houseofnorth/KK_Untitled/hardware/labels/VFD cable labels Niimbot.xlsx

Label
7 VFD_24V
8 VFD_DI1
9 VFD_OK_IN
10 GND
11 VFD_AO_IN
12 GND
T1 +24V
T2 DI1
T10 OK
T11 COM
T8 AO
T9 0V
