houseofnorth/KK_Untitled/Controller/IMG_9721.png

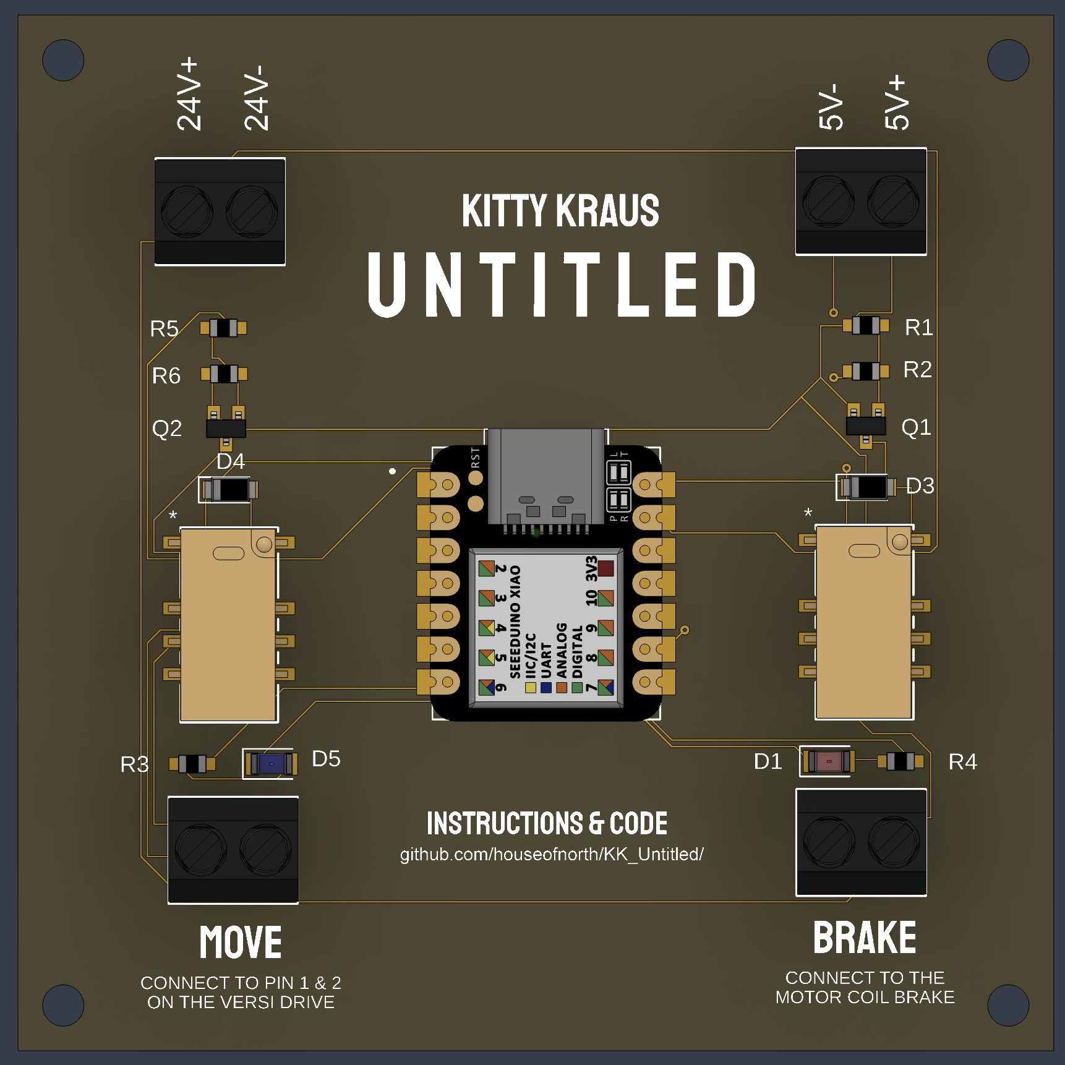
Controller/IMG_9721.png
