houseofnorth/KK_Untitled/Controller/Schematic.png

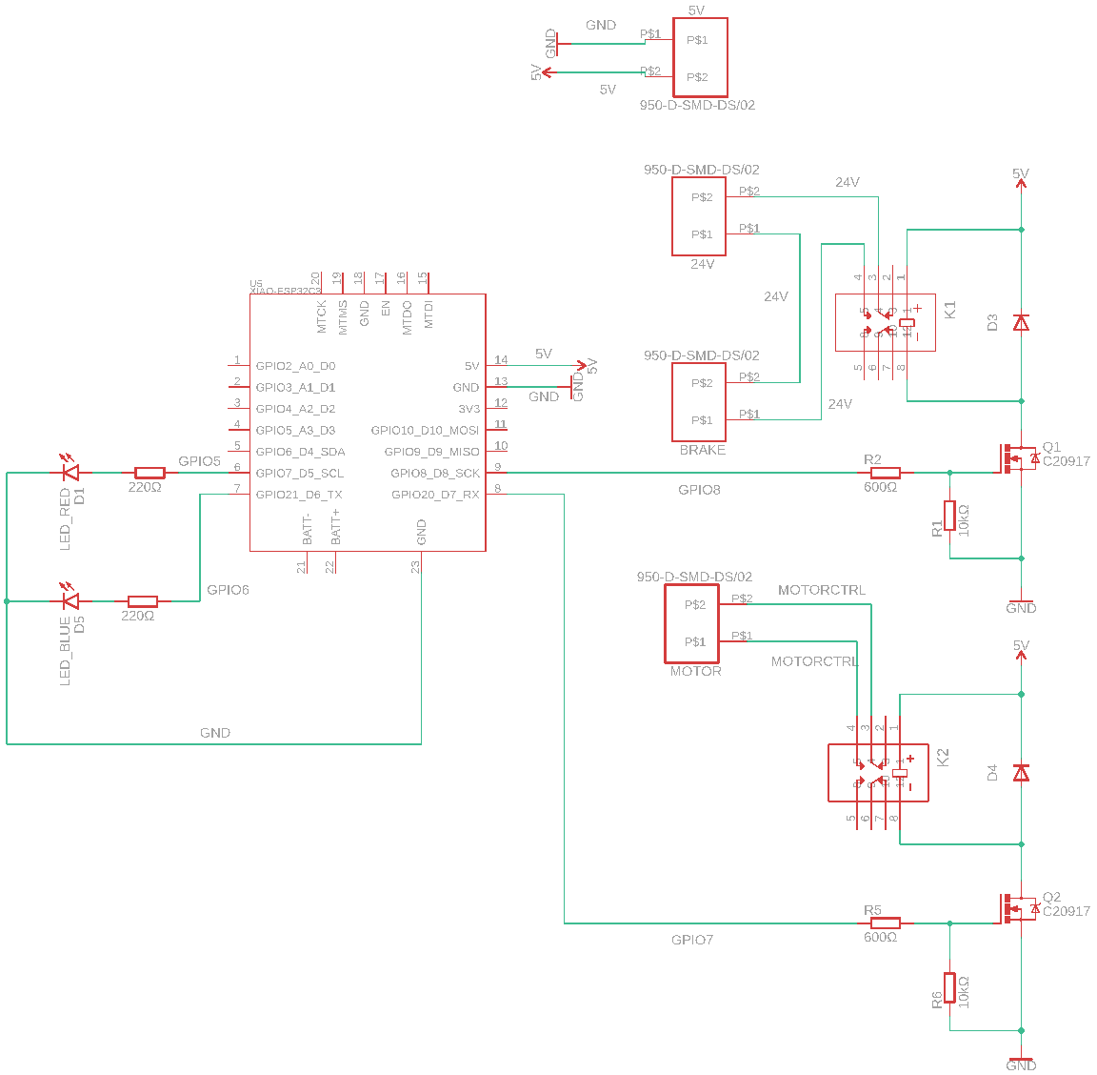
Controller/Schematic.png
