houseofnorth/KK_Untitled/hardware/Front panel.png

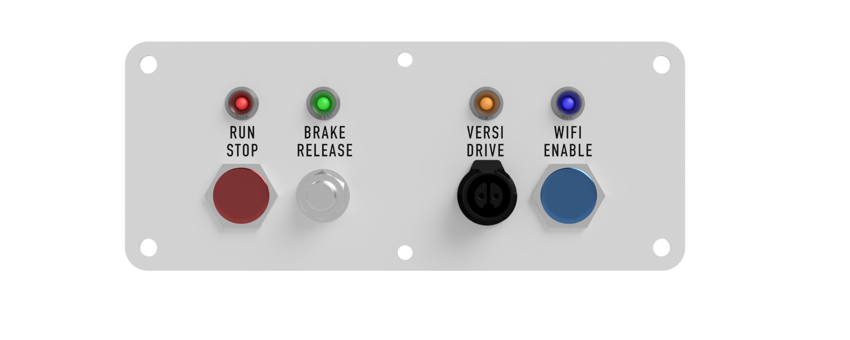
hardware/Front panel.png
