houseofnorth/KK_Untitled/firmware/Untitled/Untitled.ino

/*
------------------------------------------------------------
UNTITLED – Controller firmware (XIAO ESP32C3)
Version 1.7.8  (2026-10-18)  – keep in step with FW_VERSION below

Artist:          Kitty Kraus
Original code:   Roman Zulek (Arduino), 2011
Port / update:   Fubbi Karlsson, House of North, 2026

Behaviour (same as original):
  Run on       -> release brake, wait brakeRelease, first kick at once
  Kick         -> MOVE (VersiDrive run input) on for random spinMin..spinMax ms
  Rest         -> next kick random dropMin..dropMax ms after kick start
  Pause        -> every hangEvery..hangEveryMax ms (random): next kick in hangTime..hangTimeMax ms (random)
  Run off      -> MOVE off, brake engaged, wait brakeEngage

Added: Wi-Fi AP + mobile web page (tune, save, start/stop, test kick,
stats, OTA upload). Artist page at /, technician page at /tech,
overrides page /overrides: per-LED levels, LED test, VersiDrive check;
VersiDrive page /versidrive: documents the drive + motor nameplate, live readouts (P-08 = motorMa).
Main page nav: Main · Advanced. /tech, /overrides, /versidrive nav: all four.
Live changes apply at once; Save stores them, Undo returns to the saved state.
Wi-Fi is OFF at power-up; WIFI ENABLE switches it on (1.7.5).
AP turns off after apMinutes without use (0 = stays on): opening a page or
any action (Save, Start, slider move, ...) restarts the timer; status polling does not.

V2 options – on /overrides, saved in flash (useVfdOk and autostart ON by default, rest OFF):
  useVfdOk   VFD "drive OK" relay (VFD_OK_IN). Not OK -> move off, brake engaged.
             Resumes once OK has been stable for okResume ms. Also holds the
             piece after power-up until the drive reports ready.
  autostart  ON by default (1.6.0): mains on starts the piece (warning blink, then first push).
             Set to 0 on /tech (Settings) for installation / maintenance: the piece then stays stopped
             after power-up until RUN is held 2 s or Start is pressed.
  softKicks  First N kicks after every start ramp from 50 % to 100 % length (0 = off). Not in the UI, stays 0.

Panel buttons (1.4.0, always active, momentary to GND):
  RUN (RUN_IN)   stopped: hold 2 s = start (warning blink, then first push; may let go).
                 Short press does nothing. Starting/running: any press = stop + brake at once.
  Wi-Fi (BTN_IN) press = Wi-Fi AP on (blue blinks, then solid), or restart its timer if
                 already on. Only ever switches on; off is the idle timeout after apMinutes. NOTE: GPIO2 is a strapping pin – holding this
                 button during power-up stops the board from booting.
  Web Start/Stop behave the same as the RUN button.

Strength output – FUTURE FEATURE (V3), not fitted. hidden on /tech until fitted (page.h #future), OFF by default:
  useStr     PWM on GPIO9 (test pad) -> DFRobot GP8101S (DFR1036) set to 0-10 V -> VFD AI1 (T6).
             Strength strMin..strMax % (random), drawn after each push so the
             module output settles during the rest. Off = GPIO9 left as input.
  strInv     OFF (default) for the GP8101S: module powered from XIAO 3V3, PWM pin straight
             to GPIO9. ON only for opto-input modules wired DIN+ -> 3.3 V, DIN- -> GPIO9.
             GPIO9 is a strapping pin: the module input must not pull it low at boot.
  motorMa    VFD P-08 rated current; with P-25 = 9 the AO reads A = V(T8) x 0.2 x P-08.

Always active (indication only, cannot stop the piece):
  LED_VFD_OK  on = drive OK, breathing = not OK / not connected (stopped),
              2 Hz blink = not OK while the piece should run
  LED levels  each LED has its own level, ledRed / ledGreen / ledAmber / ledBlue (1.7.0, /overrides)
  LED_MOVE    solid = push, speeding-up blink = warning, slow breathing = running, off = stopped
  LED_SYS     Wi-Fi: 4 Hz blink while booting or starting (after WIFI ENABLE), 2 Hz blink = Wi-Fi up,
              solid = a device is connected, off = Wi-Fi off (15 min idle)
  OTA update  all four LEDs chase left to right (red, green, amber, blue)
  VFD AO      live VersiDrive analog output + peak per kick on the web page

Board: XIAO_ESP32C3 (esp32 core 3.x).
------------------------------------------------------------
*/

#include <WiFi.h>
#include <WebServer.h>
#include <ESPmDNS.h>
#include <Preferences.h>
#include <Update.h>
#include <esp_random.h>
#include "page.h"     // technician page  /tech
#include "artist.h"   // artist page      /
#include "overrides.h" // overrides page /overrides
#include "versidrive.h" // VersiDrive record /versidrive

#define FW_VERSION "1.7.8"

// --- Pins (named after the schematic nets) ---
constexpr uint8_t PIN_K1_GATE    = D10; // GPIO10 net K1_GATE   -> Q1 -> K1 : brake coil  (HIGH = brake released)
constexpr uint8_t PIN_K2_GATE    = D7;  // GPIO20 net K2_GATE   -> Q2 -> K2 : VFD_24V/VFD_DI1 contact (HIGH = run impulse)
constexpr uint8_t PIN_LED_BRAKE  = D5;  // GPIO7  net LED_BRAKE : onboard LED + panel LED via PLED_BRAKE
constexpr uint8_t PIN_LED_MOVE   = D6;  // GPIO21 net LED_MOVE  : onboard LED + panel LED via PLED_MOVE
constexpr uint8_t PIN_LED_VFD_OK = D3;  // GPIO5  net LED_VFD_OK: onboard LED3 + panel LED via PLED_VFD_OK
constexpr uint8_t PIN_LED_SYS    = D8;  // GPIO8  net LED_SYS   : LED4 + panel SYSTEM LED, ACTIVE LOW (strapping pin)
constexpr uint8_t PIN_VFD_OK_SIG = D4;  // GPIO6  net VFD_OK_SIG: drive OK relay, active low (10k pull-up)
constexpr uint8_t PIN_VFD_AO_SIG = D1;  // GPIO3  net VFD_AO_SIG: VFD analog out via 68k/10k divider
constexpr uint8_t PIN_RUN_SIG    = D2;  // GPIO4  net RUN_SIG   : RUN button, pressed = LOW (10k pull-up)
constexpr uint8_t PIN_BTN_SIG    = D0;  // GPIO2  net BTN_SIG   : Wi-Fi button, pressed = LOW (R11 pull-up, strapping pin)
constexpr uint8_t PIN_STRENGTH   = D9;  // GPIO9  test pad PIN_9 : strength PWM -> 0-10 V module -> VFD AI1 (strapping pin,
                                        //        left as input unless useStr; wire active low so it idles high)
constexpr uint32_t STR_FREQ      = 1000;  // Hz, module wants 1-3 kHz
constexpr uint8_t  STR_BITS      = 10;

constexpr float    AO_SCALE      = 7.8f;  // V at VFD terminal 8 = V at pin * 7.8
constexpr uint32_t AO_TAIL_MS    = 1500;  // keep tracking the peak this long after a kick ends
constexpr uint32_t RUN_HOLD_MS   = 2000;  // hold RUN this long to start
constexpr uint32_t BOOT_BLINK_MS = 2000;  // blue LED blinks this long after power-up
constexpr uint32_t WIFI_BLINK_MS = 1500;  // ... and after WIFI ENABLE, until Wi-Fi is up
uint32_t blueBlinkUntil = BOOT_BLINK_MS;

// --- Wi-Fi ---
const char *AP_SSID  = "Untitled";
const char *AP_PASS  = "deltitnu";       // "untitled" backwards, min 8 chars
const char *HOSTNAME = "untitled";       // http://untitled.local


// --- Config ---
struct Config {
  uint32_t spinMin, spinMax;          // ms
  uint32_t dropMin, dropMax;          // ms
  uint32_t hangEvery, hangTime;       // ms (hangEvery 0 = no pause)
  uint32_t brakeRelease, brakeEngage; // ms
  uint32_t ledPct;                    // unused since 1.7.0 (per-LED levels), kept for layout
  uint32_t apMinutes;                 // 0 = AP always on
  // --- added in CFG_VERSION 2 (V2 options) ---
  uint32_t useVfdOk;                  // 0/1
  uint32_t okResume;                  // ms drive OK must be stable before resuming
  uint32_t useRun;                    // unused since 1.4.0 (RUN is a button now), kept for layout
  uint32_t useBtn;                    // unused since 1.4.0, kept for layout
  uint32_t softKicks;                 // 0 = off
  // --- added in CFG_VERSION 3: random long pauses ---
  uint32_t hangEveryMax;              // ms, pause interval is random hangEvery..hangEveryMax
  uint32_t hangTimeMax;               // ms, pause length is random hangTime..hangTimeMax
  // --- added in CFG_VERSION 4 ---
  uint32_t warnMs;                    // Move LED speeding-up blink before each push (0 = off)
  // --- added in CFG_VERSION 5 ---
  uint32_t autostart;                 // 0/1 start on power-up
  // --- added in CFG_VERSION 6 ---
  uint32_t motorMa;                   // VFD P-08 motor rated current in mA (0 = unknown) for the A readout
  uint32_t useStr;                    // 0/1 strength PWM on GPIO9
  uint32_t strInv;                    // 1 = active low (DIN+ -> 3.3 V, DIN- -> GPIO9)
  uint32_t strMin, strMax;            // % of 0-10 V, random per push
  // --- added in CFG_VERSION 9 ---
  uint32_t vfdLedPct;                 // unused since 1.7.0, kept for layout
  // --- added in CFG_VERSION 11: per-LED levels, set on /overrides ---
  uint32_t ledRed, ledGreen, ledAmber, ledBlue;   // % 0..100
};
const Config DEFAULTS = {200, 900, 10000, 45000, 600000, 60000, 1250, 1250, 50, 15,
                         1, 5000, 0, 0, 0,
                         600000, 60000,
                         3000,
                         1,
                         0, 0, 0, 40, 100,
                         60,
                         50, 50, 30, 50};
constexpr uint32_t CFG_VERSION = 11;  // 9: + vfdLedPct · 10: autostart on by default · 11: per-LED levels
constexpr size_t   CFG_V10_SIZE = 25 * sizeof(uint32_t);
constexpr size_t   CFG_V9_SIZE = 25 * sizeof(uint32_t);
constexpr size_t   CFG_V8_SIZE = 24 * sizeof(uint32_t);
// 7: Stop on VFD fault on by default · 8: strength output active high (GP8101S)
constexpr size_t   CFG_V7_SIZE = 24 * sizeof(uint32_t);
constexpr size_t   CFG_V6_SIZE = 24 * sizeof(uint32_t);
constexpr size_t   CFG_V5_SIZE = 19 * sizeof(uint32_t);
constexpr size_t   CFG_V1_SIZE = 10 * sizeof(uint32_t);
constexpr size_t   CFG_V2_SIZE = 15 * sizeof(uint32_t);
constexpr size_t   CFG_V3_SIZE = 17 * sizeof(uint32_t);
constexpr size_t   CFG_V4_SIZE = 18 * sizeof(uint32_t);

Config cfg;
uint32_t cfgRev = 0;               // bumps on every settings change, pages re-sync on it
Config savedCfg;                   // what is in flash; cfg may hold live (unsaved) changes
Preferences prefs;
WebServer server(80);

// --- State ---
enum Phase : uint8_t { STOPPED, RELEASING, WAITING, KICKING, ENGAGING };
const char *PHASE_NAMES[] = {"stopped", "releasing brake", "resting", "kick", "engaging brake"};

Phase    phase = STOPPED;
bool     userRun = false;     // wanted on/off (web Start/Stop, RUN button)
bool     running = false;     // actually running
bool     inPause = false;     // current rest is a hangout pause
bool     brakeReleased = false, moveOn = false;
uint32_t phaseStart = 0, kickStart = 0, kickLen = 0, nextKick = 0, hangoutAt = 0;
uint32_t lastSpin = 0, lastDrop = 0, kicks = 0, pauses = 0, bootCount = 0;
uint32_t kicksSinceStart = 0, vfdFaults = 0, lastPause = 0;
int32_t  lastStr = -1;                     // strength % of the last push, -1 = output off
float    warnPhase = 0;                    // Move LED warning blink phase
bool     warnWas = false;
bool     faultActive = false;
bool     apOn = false, webReady = false;
uint32_t apSince = 0;
bool     otaActive = false;

// AO feedback
float    aoV = 0;                         // smoothed V at terminal 8
float    aoPeak = 0, aoLastPeak = -1, aoAvgPeak = -1;
bool     aoTracking = false;

// ---------- Inputs (all active low, debounced) ----------
struct Input {
  uint8_t  pin;
  uint16_t debounce;
  bool     state, raw;
  uint32_t since;          // when raw last changed
  void begin(uint32_t now) { pinMode(pin, INPUT); raw = state = digitalRead(pin) == LOW; since = now; }
  bool update(uint32_t now) {               // true when state changed
    bool r = digitalRead(pin) == LOW;
    if (r != raw) { raw = r; since = now; return false; }
    if (r != state && now - since >= debounce) { state = r; return true; }
    return false;
  }
  uint32_t stableFor(uint32_t now) const { return raw == state ? now - since : 0; }
};
Input inVfdOk = {PIN_VFD_OK_SIG, 300};   // true = drive OK
Input inRun   = {PIN_RUN_SIG,    30};    // true = RUN pressed
Input inBtn   = {PIN_BTN_SIG,    40};    // true = Wi-Fi pressed
uint32_t runDownAt = 0;
bool     runArmed = false;               // press began while stopped -> may start after RUN_HOLD_MS

// ---------- Outputs ----------
uint32_t duty(uint32_t pct) { return (255 * pct) / 100; }   // LED % -> 8-bit PWM
bool     ledTest = false;          // /overrides: all LEDs solid at their levels
uint32_t ledTestUntil = 0;         // test ends by itself unless the page keeps pinging

void setBrakeReleased(bool on) {
  brakeReleased = on;
  digitalWrite(PIN_K1_GATE, on ? HIGH : LOW);   // brake LED follows in tickIndicators
}

void setMove(bool on) {
  moveOn = on;
  digitalWrite(PIN_K2_GATE, on ? HIGH : LOW);   // move LED follows in tickIndicators
}

void safeOutputs() { setMove(false); setBrakeReleased(false); }

uint32_t randRange(uint32_t lo, uint32_t hi) {
  if (hi <= lo) return lo;
  return lo + (esp_random() % (hi - lo + 1));
}

// ---------- Strength output (GPIO9 PWM -> 0-10 V module -> VFD AI1) ----------
uint32_t strNow = 0;              // % for the next / current push
bool     strAttached = false;

void writeStrength() {            // attach/detach as useStr says, then write strNow
  if (!cfg.useStr) {
    if (strAttached) { ledcDetach(PIN_STRENGTH); strAttached = false; }
    pinMode(PIN_STRENGTH, INPUT);  // untouched: pad floats on its pull-up
    return;
  }
  if (!strAttached) { ledcAttach(PIN_STRENGTH, STR_FREQ, STR_BITS); strAttached = true; }
  const uint32_t full = (1u << STR_BITS) - 1;
  uint32_t duty = full * strNow / 100;
  ledcWrite(PIN_STRENGTH, cfg.strInv ? full - duty : duty);
}

void drawStrength() {             // new random strength, set well before the push
  strNow = randRange(cfg.strMin, cfg.strMax);
  writeStrength();
}

inline bool reached(uint32_t now, uint32_t t) { return (int32_t)(now - t) >= 0; }
inline bool blink(uint32_t now, uint32_t period) { return (now / (period / 2)) & 1; }

// ---------- Config storage ----------
void clampConfig(Config &c) {
  auto clamp = [](uint32_t &v, uint32_t lo, uint32_t hi) { v = v < lo ? lo : (v > hi ? hi : v); };
  clamp(c.spinMin, 20, 20000);     clamp(c.spinMax, 20, 20000);
  clamp(c.dropMin, 500, 3600000);  clamp(c.dropMax, 500, 3600000);
  clamp(c.hangEvery, 0, 86400000); clamp(c.hangTime, 0, 3600000);
  clamp(c.brakeRelease, 0, 10000); clamp(c.brakeEngage, 0, 10000);
  clamp(c.ledPct, 0, 100);         clamp(c.apMinutes, 0, 1440);
  clamp(c.useVfdOk, 0, 1);         clamp(c.okResume, 500, 600000);
  clamp(c.useRun, 0, 1);           clamp(c.useBtn, 0, 1);
  clamp(c.autostart, 0, 1);
  clamp(c.motorMa, 0, 50000);      clamp(c.useStr, 0, 1);  clamp(c.strInv, 0, 1);
  clamp(c.strMin, 0, 100);         clamp(c.strMax, 0, 100);
  clamp(c.vfdLedPct, 0, 100);
  clamp(c.ledRed, 0, 100);   clamp(c.ledGreen, 0, 100);
  clamp(c.ledAmber, 0, 100); clamp(c.ledBlue, 0, 100);
  if (c.strMax < c.strMin) std::swap(c.strMin, c.strMax);
  clamp(c.softKicks, 0, 50);
  clamp(c.hangEveryMax, 60000, 86400000); clamp(c.hangTimeMax, 0, 3600000);
  clamp(c.warnMs, 0, 10000);
  if (c.hangEvery && c.hangEvery < 60000) c.hangEvery = 60000;   // 0 = no long pauses
  if (c.hangEvery && c.hangEveryMax < c.hangEvery) std::swap(c.hangEvery, c.hangEveryMax);
  if (c.hangTimeMax < c.hangTime) std::swap(c.hangTime, c.hangTimeMax);
  if (c.spinMax < c.spinMin) std::swap(c.spinMin, c.spinMax);
  if (c.dropMax < c.dropMin) std::swap(c.dropMin, c.dropMax);
}

void saveConfig() {
  prefs.putBytes("cfg", &cfg, sizeof(Config));
  prefs.putUInt("ver", CFG_VERSION);
  savedCfg = cfg;
}

bool configDirty() { return memcmp(&cfg, &savedCfg, sizeof(Config)) != 0; }

void loadConfig() {
  cfg = DEFAULTS;
  uint32_t ver = prefs.getUInt("ver", 0);
  size_t   len = prefs.getBytesLength("cfg");
  if (ver == CFG_VERSION && len == sizeof(Config)) {
    prefs.getBytes("cfg", &cfg, sizeof(Config));
  } else if ((ver == 1 && len == CFG_V1_SIZE) || (ver == 2 && len == CFG_V2_SIZE) ||
             (ver == 3 && len == CFG_V3_SIZE) || (ver == 4 && len == CFG_V4_SIZE) ||
             (ver == 5 && len == CFG_V5_SIZE) || (ver == 6 && len == CFG_V6_SIZE) ||
             (ver == 7 && len == CFG_V7_SIZE) || (ver == 8 && len == CFG_V8_SIZE) ||
             (ver == 9 && len == CFG_V9_SIZE) || (ver == 10 && len == CFG_V10_SIZE)) {
    // keep tuned settings; fields added later keep their DEFAULTS
    prefs.getBytes("cfg", &cfg, len);
    if (ver < 7) cfg.useVfdOk = 1;     // 1.5.1: Stop on VFD fault on by default
    if (ver < 10) cfg.autostart = 1;   // 1.6.0: mains on starts the piece
    if (ver < 8) cfg.strInv = 0;       // 1.5.3: GP8101S takes the PWM active high
    if (ver < 11) {                    // 1.7.0: per-LED levels start from the old global level
      cfg.ledRed = cfg.ledGreen = cfg.ledBlue = cfg.ledPct;
      cfg.ledAmber = ver >= 9 ? cfg.ledPct * cfg.vfdLedPct / 100 : cfg.ledPct;
    }
    if (ver < 3) {                     // pause ranges start as the old fixed values
      cfg.hangEveryMax = cfg.hangEvery ? cfg.hangEvery : DEFAULTS.hangEveryMax;
      cfg.hangTimeMax  = cfg.hangTime;
    }
    clampConfig(cfg);
    saveConfig();
    Serial.printf("Config migrated from v%lu\n", ver);
  }
  clampConfig(cfg);
  savedCfg = cfg;
}

// ---------- Piece logic ----------
void startPiece() {
  if (running) return;
  running = true;
  inPause = false;
  kicksSinceStart = 0;
  drawStrength();
  setMove(false);
  setBrakeReleased(true);
  phase = RELEASING;
  phaseStart = millis();
  nextKick = phaseStart + max(cfg.brakeRelease, cfg.warnMs);   // first push after release + warning
  Serial.println("RUN: brake released");
}

void stopPiece() {
  if (!running) return;
  running = false;
  inPause = false;
  setMove(false);
  setBrakeReleased(false);
  phase = ENGAGING;
  phaseStart = millis();
  Serial.println("STOP: move off, brake engaged");
}

void startKick(uint32_t now) {
  kickLen  = randRange(cfg.spinMin, cfg.spinMax);
  if (cfg.softKicks && kicksSinceStart < cfg.softKicks)          // ramp 50 % -> 100 %
    kickLen = kickLen * (50 + 50 * kicksSinceStart / cfg.softKicks) / 100;
  kicksSinceStart++;
  lastDrop = randRange(cfg.dropMin, cfg.dropMax);
  lastSpin = kickLen;
  lastStr  = cfg.useStr ? (int32_t)strNow : -1;
  kickStart = now;
  nextKick  = now + lastDrop;      // measured from kick start, as original
  inPause = false;
  kicks++;
  aoPeak = 0;
  aoTracking = true;
  setMove(true);
  phase = KICKING;
  Serial.printf("KICK #%lu: %lu ms, next in %lu ms\n", kicks, kickLen, lastDrop);
}

void tickPiece(uint32_t now) {
  switch (phase) {
    case RELEASING:
      if (now - phaseStart >= cfg.brakeRelease) {
        // nextKick was set in startPiece (brake release + warning)
        hangoutAt = now + randRange(cfg.hangEvery, cfg.hangEveryMax);
        phase = WAITING;
      }
      break;
    case WAITING:
      if (cfg.hangEvery && reached(now, hangoutAt)) {
        hangoutAt = now + randRange(cfg.hangEvery, cfg.hangEveryMax);
        lastPause = randRange(cfg.hangTime, cfg.hangTimeMax);
        nextKick  = now + lastPause;
        inPause = true;
        pauses++;
        Serial.printf("PAUSE: %lu ms, next pause in %lu ms\n", lastPause, hangoutAt - now);
      } else if (reached(now, nextKick)) {
        startKick(now);
      }
      break;
    case KICKING:
      if (now - kickStart >= kickLen) {
        setMove(false);
        phase = WAITING;
        drawStrength();             // next push's strength, settles during the rest
      }
      break;
    case ENGAGING:
      if (now - phaseStart >= cfg.brakeEngage) phase = STOPPED;
      break;
    case STOPPED:
      break;
  }
}

// ---------- Inputs decide whether the piece may run ----------
const char *holdReason() {
  if (!userRun)    return "stopped";
  if (faultActive) return "VFD fault";
  return "";
}

void startAP();
void stopAP();

void tickInputs(uint32_t now) {
  // VFD drive OK
  if (inVfdOk.update(now)) Serial.printf(">> VFD_OK %s\n", inVfdOk.state ? "OK" : "NOT OK");
  if (cfg.useVfdOk) {
    if (!inVfdOk.state && !faultActive) {
      faultActive = true;
      if (running) { vfdFaults++; Serial.println("VFD FAULT: holding piece"); }
    } else if (faultActive && inVfdOk.state && inVfdOk.stableFor(now) >= cfg.okResume) {
      faultActive = false;
      Serial.println("VFD OK: resuming");
    }
  } else {
    faultActive = false;
  }

  // RUN button: starting/running -> any press stops at once; stopped -> hold RUN_HOLD_MS to start
  if (inRun.update(now) && inRun.state) {
    if (userRun) {
      userRun = false; runArmed = false;
      Serial.println("RUN button: stop");
    } else {
      runDownAt = now; runArmed = true;
    }
  }
  if (!inRun.state) runArmed = false;    // released before 2 s: nothing
  if (runArmed && now - runDownAt >= RUN_HOLD_MS) {
    runArmed = false;
    userRun = true;                      // warning blink starts now, operator may let go
    Serial.println("RUN button: start");
  }

  // Wi-Fi button: only ever switches Wi-Fi on (or restarts its 15 min if already on);
  // the blue LED blinks while it starts, then goes solid
  if (inBtn.update(now) && inBtn.state && !otaActive) {
    if (!apOn) startAP();
    apSince = millis();
    blueBlinkUntil = millis() + WIFI_BLINK_MS;
    Serial.println("Wi-Fi button: AP on, timer restarted");
  }

  // Apply
  bool want = userRun && !faultActive;
  if (want && !running) startPiece();
  else if (!want && running) stopPiece();
}

void tickAO(uint32_t now) {
  static uint32_t last = 0;
  if (now - last < 20) return;
  last = now;
  float v = analogReadMilliVolts(PIN_VFD_AO_SIG) * AO_SCALE / 1000.0f;
  aoV = aoV * 0.7f + v * 0.3f;
  if (aoTracking) {
    if (aoV > aoPeak) aoPeak = aoV;
    if (phase != KICKING && now - kickStart >= kickLen + AO_TAIL_MS) {
      aoTracking = false;
      aoLastPeak = aoPeak;
      aoAvgPeak  = aoAvgPeak < 0 ? aoPeak : aoAvgPeak * 0.8f + aoPeak * 0.2f;
    }
  }
}

bool moveWarning(uint32_t now) {
  return cfg.warnMs && running && !otaActive && (phase == RELEASING || phase == WAITING) &&
         (int32_t)(nextKick - now) <= (int32_t)cfg.warnMs;
}

// Slow breathing: 10 % .. 100 % of the LED's level (full = its duty), cosine fade.
// t0 = when breathing started; it starts at full brightness and fades down,
// so it joins smoothly onto a solid or blinking LED.
uint32_t breathe(uint32_t now, uint32_t period, uint32_t t0, uint32_t full) {
  float x = 0.5f + 0.5f * cosf(6.2831853f * (float)((now - t0) % period) / period);   // 1..0..1
  float lvl = 0.10f + 0.90f * x * x;                                                   // eased, perceptual
  return (uint32_t)(full * lvl);
}

void tickIndicators(uint32_t now) {
  const uint32_t R = duty(cfg.ledRed), G = duty(cfg.ledGreen), A = duty(cfg.ledAmber), B = duty(cfg.ledBlue);
  if (ledTest && !reached(now, ledTestUntil)) {   // /overrides LED test: all solid at their levels
    ledcWrite(PIN_LED_MOVE, R); ledcWrite(PIN_LED_BRAKE, G);
    ledcWrite(PIN_LED_VFD_OK, A); ledcWrite(PIN_LED_SYS, 256 - B);
    return;
  }
  ledTest = false;
  if (otaActive) {                              // firmware upload: chase left to right, red -> blue
    const uint8_t pins[4] = {PIN_LED_MOVE, PIN_LED_BRAKE, PIN_LED_VFD_OK, PIN_LED_SYS};
    const uint32_t lvl[4] = {R, G, A, B};
    uint8_t step = (now / 120) % 4;
    for (uint8_t i = 0; i < 4; i++) {
      uint32_t d = i == step ? lvl[i] : (i == (step + 3) % 4 ? lvl[i] / 5 : 0);   // lit + short tail
      ledcWrite(pins[i], pins[i] == PIN_LED_SYS ? 256 - d : d);
    }
    return;
  }
  ledcWrite(PIN_LED_BRAKE, brakeReleased ? G : 0);
  // VFD LED: on = drive OK, breathing = not OK / not connected while stopped,
  //          2 Hz blink = not OK while the piece should run (fault)
  static uint32_t vbStart = 0;
  static bool vbWas = false;
  bool vb = !inVfdOk.state && !userRun;
  if (vb && !vbWas) vbStart = now;            // breathing starts at full brightness
  vbWas = vb;
  uint32_t vDuty;
  if (inVfdOk.state)  vDuty = A;
  else if (userRun)   vDuty = blink(now, 500) ? A : 0;
  else                vDuty = breathe(now, 3000, vbStart, A);
  ledcWrite(PIN_LED_VFD_OK, vDuty);
  // System LED (active low) = Wi-Fi: fast blink while booting / starting, 2 Hz blink = Wi-Fi up
  // (same tempo as the amber fault blink), solid = a device is connected, off = Wi-Fi off
  // (OTA: chase, handled above)
  static uint32_t lastSta = 0;
  static uint8_t  sta = 0;
  if (now - lastSta >= 500) { lastSta = now; sta = apOn ? WiFi.softAPgetStationNum() : 0; }
  uint32_t sDuty;
  if (!reached(now, blueBlinkUntil)) sDuty = blink(now, 250) ? B : 0;   // booting / Wi-Fi starting
  else if (!apOn)                    sDuty = 0;                          // Wi-Fi off
  else if (sta > 0)                  sDuty = B;                          // device connected: solid
  else                               sDuty = blink(now, 500) ? B : 0;   // Wi-Fi up, waiting: 2 Hz
  ledcWrite(PIN_LED_SYS, 256 - sDuty);              // active low: 256 = pin held high = fully off

  // Move LED, highest first: solid while pushing; speeding-up blink during the
  // warning before a push; slow breathing while running between pushes; off when stopped
  static uint32_t lastT = 0;
  uint32_t dt = now - lastT; lastT = now;
  bool warn = moveWarning(now);
  if (warn && !warnWas) warnPhase = 0;
  warnWas = warn;
  static uint32_t brStart = 0;
  static bool brWas = false;
  uint32_t mDuty = 0;
  bool br = !moveOn && !warn && running && !otaActive;
  if (br && !brWas) brStart = now;            // start each breathing spell at full brightness
  brWas = br;
  if (moveOn) {
    mDuty = R;
  } else if (warn) {
    float f = 1.0f - (float)(int32_t)(nextKick - now) / cfg.warnMs;   // 0 -> 1 over the warning
    if (f < 0) f = 0;
    float period = 700.0f - 620.0f * f;                               // 700 ms -> 80 ms
    warnPhase += dt / period;
    mDuty = (warnPhase - (int)warnPhase) < 0.5f ? R : 0;
  } else if (br) {
    mDuty = breathe(now, 3000, brStart, R);
  }
  ledcWrite(PIN_LED_MOVE, mDuty);
}

// ---------- Web ----------
void sendJson(const String &s) {
  server.sendHeader("Cache-Control", "no-store");
  server.send(200, "application/json", s);
}

String configJson() {
  char b[1000];
  snprintf(b, sizeof b,
    "{\"spinMin\":%lu,\"spinMax\":%lu,\"dropMin\":%lu,\"dropMax\":%lu,"
    "\"hangEvery\":%lu,\"hangTime\":%lu,\"brakeRelease\":%lu,\"brakeEngage\":%lu,"
    "\"ledRed\":%lu,\"ledGreen\":%lu,\"ledAmber\":%lu,\"ledBlue\":%lu,\"apMinutes\":%lu,"
    "\"useVfdOk\":%lu,\"okResume\":%lu,\"useRun\":%lu,\"useBtn\":%lu,\"softKicks\":%lu,"
    "\"hangEveryMax\":%lu,\"hangTimeMax\":%lu,\"warnMs\":%lu,\"autostart\":%lu,"
    "\"motorMa\":%lu,\"useStr\":%lu,\"strInv\":%lu,\"strMin\":%lu,\"strMax\":%lu,\"rev\":%lu}",
    cfg.spinMin, cfg.spinMax, cfg.dropMin, cfg.dropMax, cfg.hangEvery, cfg.hangTime,
    cfg.brakeRelease, cfg.brakeEngage, cfg.ledRed, cfg.ledGreen, cfg.ledAmber, cfg.ledBlue, cfg.apMinutes,
    cfg.useVfdOk, cfg.okResume, cfg.useRun, cfg.useBtn, cfg.softKicks,
    cfg.hangEveryMax, cfg.hangTimeMax, cfg.warnMs, cfg.autostart,
    cfg.motorMa, cfg.useStr, cfg.strInv, cfg.strMin, cfg.strMax, cfgRev);
  return String(b);
}

String statusJson() {
  uint32_t now = millis();
  long nextKickIn = (running && phase == WAITING) ? (long)(int32_t)(nextKick - now) : -1;
  long pauseIn    = (running && cfg.hangEvery && phase != RELEASING) ? (long)(int32_t)(hangoutAt - now) : -1;
  long apOffIn    = (apOn && cfg.apMinutes) ? max(0L, (long)cfg.apMinutes * 60000L - (long)(now - apSince)) : -1;
  const char *ph  = (phase == WAITING && inPause) ? "pause" : PHASE_NAMES[phase];
  char b[1100];
  snprintf(b, sizeof b,
    "{\"fw\":\"%s\",\"running\":%s,\"userRun\":%s,\"hold\":\"%s\",\"phase\":\"%s\",\"brake\":%s,\"move\":%s,"
    "\"uptime\":%lu,\"boots\":%lu,\"kicks\":%lu,\"pauses\":%lu,\"lastSpin\":%lu,\"lastDrop\":%lu,"
    "\"nextKickIn\":%ld,\"pauseIn\":%ld,\"apOffIn\":%ld,\"clients\":%d,\"heap\":%lu,"
    "\"vfdOk\":%s,\"runSw\":%s,\"btn\":%s,\"faults\":%lu,\"ao\":%.2f,\"aoPeak\":%.2f,\"aoAvg\":%.2f,"
    "\"dirty\":%s,\"hangTime\":%lu,\"warn\":%s,\"str\":%ld,\"lastStr\":%ld,\"ledTest\":%s,\"rev\":%lu}",
    FW_VERSION, running ? "true" : "false", userRun ? "true" : "false",
    running ? "" : holdReason(), ph,
    brakeReleased ? "\"released\"" : "\"engaged\"", moveOn ? "true" : "false",
    now / 1000, bootCount, kicks, pauses, lastSpin, lastDrop,
    nextKickIn, pauseIn, apOffIn, WiFi.softAPgetStationNum(),
    (unsigned long)ESP.getFreeHeap(),
    inVfdOk.state ? "true" : "false", inRun.state ? "true" : "false", inBtn.state ? "true" : "false",
    vfdFaults, aoV, aoLastPeak, aoAvgPeak,
    configDirty() ? "true" : "false", lastPause, moveWarning(now) ? "true" : "false",
    cfg.useStr ? (long)strNow : -1L, (long)lastStr,
    (ledTest && !reached(now, ledTestUntil)) ? "true" : "false", cfgRev);
  return String(b);
}

// Read config fields from the request (missing ones keep their current value)
Config configFromArgs() {
  Config c = cfg;
  auto rd = [](const char *k, uint32_t &v) {
    if (server.hasArg(k)) { long x = server.arg(k).toInt(); v = x < 0 ? 0 : (uint32_t)x; }
  };
  rd("spinMin", c.spinMin);   rd("spinMax", c.spinMax);
  rd("dropMin", c.dropMin);   rd("dropMax", c.dropMax);
  rd("hangEvery", c.hangEvery); rd("hangTime", c.hangTime);
  rd("brakeRelease", c.brakeRelease); rd("brakeEngage", c.brakeEngage);
  rd("ledRed", c.ledRed);     rd("ledGreen", c.ledGreen);
  rd("ledAmber", c.ledAmber); rd("ledBlue", c.ledBlue);
  rd("apMinutes", c.apMinutes);
  rd("useVfdOk", c.useVfdOk); rd("okResume", c.okResume);
  rd("useRun", c.useRun);     rd("useBtn", c.useBtn);
  rd("softKicks", c.softKicks);
  rd("hangEveryMax", c.hangEveryMax); rd("hangTimeMax", c.hangTimeMax);
  rd("warnMs", c.warnMs);
  rd("autostart", c.autostart);
  rd("motorMa", c.motorMa);   rd("useStr", c.useStr);   rd("strInv", c.strInv);
  rd("strMin", c.strMin);     rd("strMax", c.strMax);
  clampConfig(c);
  return c;
}

// Make a config active right away (not saved)
void applyConfig(const Config &c) {
  Config old = cfg;
  cfg = c;
  if (memcmp(&old, &cfg, sizeof(Config)) != 0) cfgRev++;
  uint32_t now = millis();
  if (running && cfg.hangEvery && (cfg.hangEvery != old.hangEvery || cfg.hangEveryMax != old.hangEveryMax))
    hangoutAt = now + randRange(cfg.hangEvery, cfg.hangEveryMax);
  // New rest range: re-draw the current rest so the change is felt at once
  if (running && phase == WAITING && !inPause &&
      (cfg.dropMin != old.dropMin || cfg.dropMax != old.dropMax)) {
    lastDrop = randRange(cfg.dropMin, cfg.dropMax);
    nextKick = kickStart + lastDrop;
  }
  if (cfg.useStr != old.useStr || cfg.strInv != old.strInv ||
      cfg.strMin != old.strMin || cfg.strMax != old.strMax) {
    if (moveOn) writeStrength();     // mid-push: keep this push's value
    else drawStrength();
  }
  tickInputs(now);                   // apply option changes at once
}

void setupWeb() {
  server.on("/", HTTP_GET, [] { apSince = millis();
    server.sendHeader("Cache-Control", "no-store");
    server.send_P(200, "text/html", ARTIST_HTML);
  });
  server.on("/tech", HTTP_GET, [] { apSince = millis();
    server.sendHeader("Cache-Control", "no-store");
    server.send_P(200, "text/html", INDEX_HTML);
  });
  server.on("/overrides", HTTP_GET, [] { apSince = millis();   // linked from /tech and /versidrive only
    server.sendHeader("Cache-Control", "no-store");
    server.send_P(200, "text/html", OVERRIDES_HTML);
  });
  server.on("/versidrive", HTTP_GET, [] { apSince = millis();
    server.sendHeader("Cache-Control", "no-store");
    server.send_P(200, "text/html", VERSIDRIVE_HTML);
  });
  server.on("/setup", HTTP_GET, [] { server.sendHeader("Location", "/versidrive"); server.send(302); });
  server.on("/api/setup", HTTP_GET, [] {             // site record, stored as-is
    String d = prefs.getString("setup", "{}");
    sendJson(d.length() ? d : String("{}"));
  });
  server.on("/api/setup", HTTP_POST, [] { apSince = millis();   // activity keeps Wi-Fi on
    String d = server.arg("d");
    if (!d.startsWith("{") || d.length() > 2500) { server.send(400, "text/plain", "bad"); return; }
    prefs.putString("setup", d);
    sendJson(d);
  });
  server.on("/api/ledtest", HTTP_POST, [] { apSince = millis();         // on=1 holds all LEDs solid for 10 s, page pings
    ledTest = server.arg("on") == "1";
    ledTestUntil = millis() + 10000;
    sendJson(statusJson());
  });
  server.on("/api/status", HTTP_GET, [] { sendJson(statusJson()); });
  server.on("/api/config", HTTP_GET, [] { sendJson(configJson()); });
  server.on("/api/config", HTTP_POST, [] { apSince = millis();           // apply + save
    applyConfig(configFromArgs()); saveConfig();
    Serial.println("Config saved");
    sendJson(configJson());
  });
  server.on("/api/live", HTTP_POST, [] { apSince = millis();             // apply, not saved
    applyConfig(configFromArgs());
    sendJson(configJson());
  });
  server.on("/api/revert", HTTP_POST, [] { apSince = millis();           // back to the saved config
    applyConfig(savedCfg);
    sendJson(configJson());
  });
  server.on("/api/defaults", HTTP_POST, [] { apSince = millis();   // activity keeps Wi-Fi on
    applyConfig(DEFAULTS); saveConfig();
    sendJson(configJson());
  });
  server.on("/api/start", HTTP_POST, [] { apSince = millis(); userRun = true;  tickInputs(millis()); sendJson(statusJson()); });
  server.on("/api/stop",  HTTP_POST, [] { apSince = millis(); userRun = false; tickInputs(millis()); sendJson(statusJson()); });
  server.on("/api/kick",  HTTP_POST, [] { apSince = millis();            // push after the warning
    uint32_t now = millis(), due = now + cfg.warnMs;
    if (running && phase == WAITING && (int32_t)(nextKick - due) > 0) {
      nextKick = due; lastDrop = nextKick - kickStart; inPause = false;
    }
    sendJson(statusJson());
  });
  server.on("/api/wifi", HTTP_POST, [] { apSince = millis();             // restart the Wi-Fi off timer
    apSince = millis();
    sendJson(statusJson());
  });
  server.on("/api/reboot", HTTP_POST, [] { apSince = millis();   // activity keeps Wi-Fi on
    server.send(200, "text/plain", "rebooting");
    safeOutputs(); delay(300); ESP.restart();
  });

  // OTA: upload Untitled.ino.bin
  server.on("/update", HTTP_POST, [] { apSince = millis();   // activity keeps Wi-Fi on
    bool ok = !Update.hasError();
    server.sendHeader("Connection", "close");
    server.send(ok ? 200 : 500, "text/plain", ok ? "OK" : Update.errorString());
    otaActive = false;
    if (ok) { prefs.putBool("wifiNext", true); delay(500); ESP.restart(); }   // Wi-Fi back on after the update
  }, [] {
    HTTPUpload &up = server.upload();
    if (up.status == UPLOAD_FILE_START) {
      otaActive = true;
      running = false; phase = STOPPED; safeOutputs();   // piece safe during update
      Serial.printf("OTA start: %s\n", up.filename.c_str());
      if (!Update.begin(UPDATE_SIZE_UNKNOWN)) Update.printError(Serial);
    } else if (up.status == UPLOAD_FILE_WRITE) {
      if (Update.write(up.buf, up.currentSize) != up.currentSize) Update.printError(Serial);
      tickIndicators(millis());                      // keep the chase running during the upload
    } else if (up.status == UPLOAD_FILE_END) {
      if (Update.end(true)) Serial.printf("OTA done: %u bytes\n", up.totalSize);
      else Update.printError(Serial);
    } else if (up.status == UPLOAD_FILE_ABORTED) {
      Update.abort(); otaActive = false;
    }
  });

  server.onNotFound([] { server.sendHeader("Location", "/"); server.send(302); });
}

void startAP() {
  WiFi.mode(WIFI_AP);
  WiFi.softAP(AP_SSID, AP_PASS);
  WiFi.setSleep(false);              // snappier web page
  MDNS.begin(HOSTNAME);
  MDNS.addService("http", "tcp", 80);
  if (!webReady) { setupWeb(); webReady = true; }
  server.begin();
  apOn = true;
  apSince = millis();
  Serial.printf("AP %s up at %s\n", AP_SSID, WiFi.softAPIP().toString().c_str());
}

void stopAP() {
  server.stop();
  MDNS.end();
  WiFi.softAPdisconnect(true);
  WiFi.mode(WIFI_OFF);
  apOn = false;
  Serial.println("AP off");
}

// ---------- Main ----------
void setup() {
  // Safe state first: brake engaged, VersiDrive not running
  pinMode(PIN_K1_GATE, OUTPUT); digitalWrite(PIN_K1_GATE, LOW);
  pinMode(PIN_K2_GATE, OUTPUT); digitalWrite(PIN_K2_GATE, LOW);
  ledcAttach(PIN_LED_BRAKE,  5000, 8);
  ledcAttach(PIN_LED_MOVE,   5000, 8);
  ledcAttach(PIN_LED_VFD_OK, 5000, 8);
  ledcAttach(PIN_LED_SYS,    5000, 8);
  ledcWrite(PIN_LED_SYS, 0);                       // active low: on at once, boot blink follows in loop

  uint32_t now = millis();
  inVfdOk.begin(now); inRun.begin(now); inBtn.begin(now);
  analogSetPinAttenuation(PIN_VFD_AO_SIG, ADC_11db);

  Serial.begin(115200);
  prefs.begin("kk", false);
  bootCount = prefs.getUInt("boots", 0) + 1;
  prefs.putUInt("boots", bootCount);
  loadConfig();
  safeOutputs();
  drawStrength();                                  // no-op unless the strength output is on
  Serial.printf("\nUNTITLED fw %s, boot #%lu | VFD_OK %s, autostart %s, soft %lu\n",
                FW_VERSION, bootCount, cfg.useVfdOk ? "on" : "off",
                cfg.autostart ? "on" : "off", cfg.softKicks);

  if (prefs.getBool("wifiNext", false)) {        // right after a firmware update: Wi-Fi on, to check the new version
    prefs.putBool("wifiNext", false);
    startAP();
  } else {
    WiFi.mode(WIFI_OFF);                           // otherwise Wi-Fi stays off until WIFI ENABLE is pressed
  }
  userRun = cfg.autostart;                         // mains on = start (untick Autostart for maintenance)
  faultActive = cfg.useVfdOk && !inVfdOk.state;    // wait for drive ready
  tickInputs(millis());
}

void loop() {
  uint32_t now = millis();
  if (!otaActive) {
    tickInputs(now);
    tickPiece(now);
  }
  tickAO(now);
  tickIndicators(now);

  if (apOn) {
    server.handleClient();
    static uint32_t lastApCheck = 0;
    uint32_t t = millis();             // fresh: apSince may have been set after 'now' (button, web request)
    if (cfg.apMinutes && t - lastApCheck > 1000) {
      lastApCheck = t;
      if ((int32_t)(t - apSince) > (int32_t)(cfg.apMinutes * 60000UL) && !otaActive) stopAP();   // idle timeout
    }
  }
  delay(1);
}
