houseofnorth/KK_Untitled/(commit log)

2026-03-06 Updated to compile in Arduino 2.3.8
2026-03-06 Updated for Arduino 2.3.8
2026-03-06 Added device manuals
2026-03-06 Schematic and image
2026-09-21 Add XIAO ESP32C3 controller: test firmware, hardware folders, README
2026-09-21 ControllerTest: use XIAO D-pin macros (D5-D8) for pin map; ignore sketch build dirs
2026-09-21 Fix controller pin map: schematic nets are XIAO D-pins (K2=D7/GPIO20, LEDs=D5/D6)
2026-09-25 Controller V2: production files as ordered at JLCPCB, V2 pin map
    - Controller V2/: README (pin map, MOTOR/PANEL connectors, JLC ordering notes),
    BOMs, CAM 02 Gerbers + BOM + CPL (ordered 2026-09-25), board render,
    enclosure panel and VFD analog feedback diagrams
    - K1/K2 now Omron G6S-2F-TR DC5 (C397130)
    - Firmware: V2 pin map (K1_GATE=D10, K2_GATE=D7, inputs and status LEDs)
    - READMEs point to V2
2026-10-12 Untitled 1.4.0: RUN + Wi-Fi panel buttons, no auto restart after power cut (Autostart option on /tech), README
2026-10-12 Untitled 1.5.0: motor current in A (P-08), push slider soft/hard, optional strength PWM on GPIO9 (0-10 V module -> AI1)
2026-10-12 V2 README: brake on M12 socket, pins 1/3
2026-10-15 Untitled 1.5.1: breathing run LED, VFD LED breathes when drive not OK / blinks 2 Hz on fault, Stop on VFD fault on by default
2026-10-15 Untitled 1.5.2: amber VFD LED at 80 %
2026-10-15 Untitled 1.5.3 + docs sync
    - Firmware 1.5.3: strength output defaults to active high (GP8101S), header/UI text cleaned (no RUN switch)
    - READMEs: panel LED colours and behaviour, silkscreen names, bench test with 9-10 switch, GP8101S wiring, file list
    - Panel SVG: buttons, LED colours, Quick-Lock 6, P-25 = 9
    - Add V2 BoardTest sketch, cable/LED label sheets (Niimbot), VFD cable graphics, site fault check
2026-10-15 Untitled 1.5.4: amber VFD LED at 60 %
2026-10-15 Untitled 1.5.6: /tech status shows all four panel LEDs in their colours
2026-10-15 Untitled 1.5.7: /tech LED order matches the panel (run, Wi-Fi, VFD, brake)
2026-10-15 Untitled 1.5.10: /tech status lights Motor, Brake, VFD, Wi-Fi
2026-10-15 Untitled 1.5.11: temporary Amber LED level setting on /tech (default 60 %)
2026-10-16 Restructure: firmware/ and hardware/ at root, client README, HARDWARE.md, FIRMWARE.md
    - One firmware only (firmware/Untitled); original code, ControllerTest, BoardTest and V1 files removed (still in history)
    - hardware/: production files, BOMs, drawings, QR, Niimbot label sheets
    - README is now the client guide: start/stop, buttons, lights, settings page, help
2026-10-16 README: front panel picture, lights above, buttons and sockets below
2026-10-16 Move HARDWARE.md and FIRMWARE.md into their folders, add current firmware bin (1.6.1)
2026-10-16 PCB top/bottom images: README header and HARDWARE.md
2026-10-16 Crop white space from PCB and front panel images
2026-10-16 README: board image 2/3 width with credits beside it
2026-10-18 Firmware 1.7.1: overrides and setup pages, per-LED levels, nav bar, upload chase, blue LED states; docs and update guide
2026-10-18 Firmware 1.7.8: VersiDrive page, Wi-Fi off at power-up, WIFI ENABLE only switches on, idle timeout fix, blue light states; docs
